ktmizugaki/wifi-voice-clock/circuit/wifi_voice_clock-v3.kicad_pcb

## KiCad design circuit/wifi_voice_clock-v3.kicad_pcb (2022-05-02)

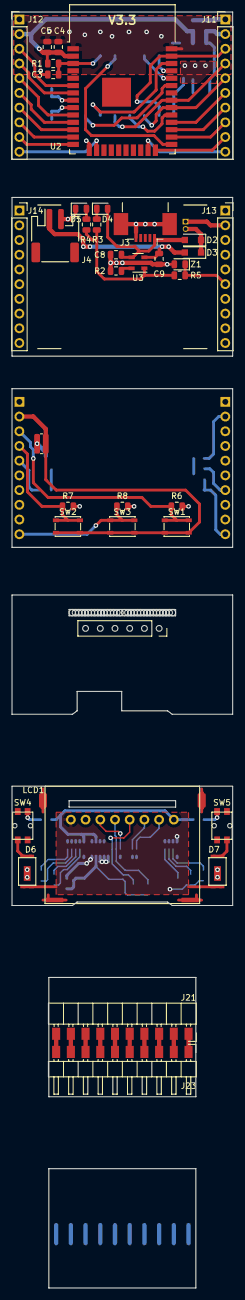
[picture p1: board wifi_voice_clock-v3.kicad_pcb from above]

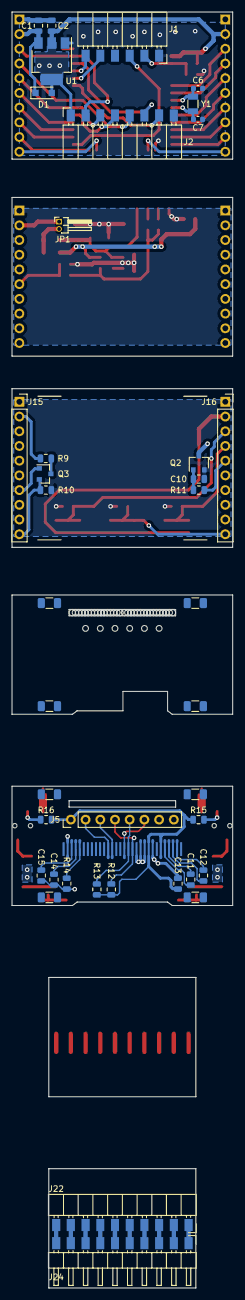
[picture p2: board wifi_voice_clock-v3.kicad_pcb from below]

Board: 2 copper layers, 38.1 x 220.3 mm, 68 parts (31 on the bottom side), 88 nets.

Parts:
C1, C2, C10, C11, C12, C13: 1uF; C_0805_2012Metric
C3, C4: 0.1uF; C_0805_2012Metric
C5, C8, C9: 10uF; C_0805_2012Metric
C6, C7: 15pF; C_0603_1608Metric
C14: 4.7uF; C_0805_2012Metric
C15: 2.2uF; C_0805_2012Metric
D1, D2: GS1010FL; D_SOD-123F
D3: SS2040FL; D_SOD-123F
D4: Orange; LED_0805_2012Metric
D5: Grean; LED_0805_2012Metric
D6, D7: SPMWHT541MD5WAR0SD; LM561B
J1: PinSocket 1x06 5.7mm; PinSocket_1x06_P2.54mm_5.7mm_Horizontal_SMD
J2: PinSocket 1x08 5.7mm; PinSocket_1x08_P2.54mm_5.7mm_Horizontal_SMD
J3: USB_B_Mini; USB_Mini-B_Hirose_UX60SC-MB-5ST
J4: BATTERY; JST_PH_S2B-PH-SM4-TB_1x02-1MP_P2.00mm_Horizontal
J5: PinHeader 1x08 7.7mm; PinHeader_1x08_P2.54mm_Vertical
J11, J12: PinHeader 1x10 7.7mm; PinHeader_1x10_P2.54mm_Vertical
J13, J14, J15, J16: PinSocket 1x10 3.5mm; PinSocket_1x10_P2.54mm_Vertical
J21, J22: PinSocket 1x10 3.5mm; PinSocket_1x10_P2.54mm_3.5mm_Horizontal_SMD
J23, J24: PinHeader 1x10 3mm; PinHeader_1x10_P2.54mm_3mm_Horizontal_SMD
JP1: Jumper; PinHeader_1x02_P1.27mm_Horizontal
LCD1: ER-OLED0.96; OLED0.96
LS1: CES-20134-088PM; R_0612_1632Metric
Q2: 2SC3265-Y; SC-59
Q3: BSS138; SOT-23
R1, R2, R5, R6, R7, R8, R10, R12, R13: 10K; R_0805_2012Metric
R3, R4: 470; R_0805_2012Metric
R9: 40K; R_0805_2012Metric
R11: 820; R_0805_2012Metric
R14: 910K; R_0805_2012Metric
R15, R16: 1K; R_0805_2012Metric
SW1, SW2, SW3: SW_Push; SW_SPST_PTS810
SW4, SW5: THAU13
U1: ADP3338AKCZ-3.3; SOT-223-3_TabPin2
U2: ESP32-WROOM-32D; ESP32-WROOM-32
U3: MCP73831-2-OT; SOT-23-5
Y1: FC-135; Crystal_SMD_3215-2Pin_3.2x1.5mm
Z1: 3.3V; D_0805_2012Metric

Connections:
+3V3: C2.1, C4.2, C5.2, D1.2, J2.1, J12.2, R1.2, U1.2, U2.2
+5V: C8.1, D2.2, D4.2, J3.1, U3.4
+BATT: C9.2, D3.2, J4.1, U3.3
/CHGR_GND: C8.2, C9.1, D5.1, J3.5, J3.6, J4.2, J13.1, J14.1, R2.1, U3.2, Z1.2
/CHGR_STAT: J13.6, R5.2, Z1.1
/CHGR_VCC: J13.2, JP1.1
/CPU_EN: C3.1, J1.2, R1.1, U2.3
/CPU_IO0: J1.3, U2.25
/CPU_IO2: J11.9, U2.24
/CPU_IO4: J11.8, U2.26
/CPU_IO12: J12.9, U2.14
/CPU_IO13: J12.10, U2.16
/CPU_IO14: J12.8, U2.13
/CPU_IO15: J11.10, U2.23
/CPU_IO16: J11.7, U2.27
/CPU_IO17: J11.6, U2.28
/CPU_IO27: J12.7, U2.12
/CPU_RXD0: J1.5, U2.34
/CPU_SPK: J12.5, U2.10
/CPU_SPK2: J12.6, U2.11
/CPU_SW1: J12.3, U2.6
/CPU_SW2: J12.4, U2.7
/CPU_TXD0: J1.6, U2.35
/CPU_VSPICLK: J2.3, J11.5, U2.30
/CPU_VSPICS0: J2.4, U2.29
/CPU_VSPID: J2.2, J11.3, U2.37
/CPU_VSPIHD: J2.7, U2.33
/CPU_VSPIQ: J2.5, J11.4, U2.31
/CPU_VSPIWP: J2.6, U2.36
/CTRL_3V3: J16.2, LS1.1, SW1.2, SW2.2, SW3.2
/CTRL_GND: C10.2, J15.1, J16.1, Q2.2, R6.1, R7.1, R8.1, R10.1
/CTRL_SPK: J16.5, R11.2
/CTRL_SW1: J16.3, R6.2, SW1.1
/CTRL_SW2: J16.4, R7.2, SW2.1
/CTRL_SW3: J16.10, R8.2, SW3.1
/CTRL_VCC: J15.2, R9.2
/CTRL_VMES: J15.10, Q3.2, R10.2
/CTRL_VOUT: J15.7, Q3.1
/LCD_3V3: C13.2, J5.1, LCD1.6, LCD1.9, R12.2, R13.2, R15.2, R16.2
/LCD_GND: C13.1, C14.2, C15.2, D6.1, D7.1, J5.8, LCD1.8, LCD1.10, LCD1.11, LCD1.12, LCD1.29, R14.2
/LCD_LCDRS: J5.6, LCD1.15
/LCD_SCLK: J5.3, LCD1.18
/LCD_SDI: J5.2, LCD1.19
/MCP73831_STAT: R3.1, R4.1, R5.1, U3.1
/~LCD_LCDCS: J5.4, LCD1.13, R12.1
/~LCD_LCDRST: J5.5, LCD1.14, R13.1
GND: C1.2, C2.2, C3.2, C4.1, C5.1, C6.1, C7.1, J1.1, J2.8, J11.1, J12.1, U1.1, U2.1, U2.15, U2.38
unnamed: C6.2, U2.8, Y1.1
unnamed: C7.2, U2.9, Y1.2
unnamed: C10.1, Q2.1, R11.1
unnamed: C11.1, LCD1.4
unnamed: C11.2, LCD1.5
unnamed: C12.1, LCD1.2
unnamed: C12.2, LCD1.3
unnamed: C14.1, LCD1.27
unnamed: C15.1, LCD1.28
unnamed: D2.1, D3.1, JP1.2
unnamed: D4.1, R3.2
unnamed: D5.2, R4.2
unnamed: D6.2, SW4.1
unnamed: D7.2, SW5.1
unnamed: J21.1, J23.1
unnamed: J21.2, J23.2
unnamed: J21.3, J23.3
unnamed: J21.4, J23.4
unnamed: J21.5, J23.5
unnamed: J21.6, J23.6
unnamed: J21.7, J23.7
unnamed: J21.8, J23.8
unnamed: J21.9, J23.9
unnamed: J21.10, J23.10
unnamed: J22.1, J24.1
unnamed: J22.2, J24.2
unnamed: J22.3, J24.3
unnamed: J22.4, J24.4
unnamed: J22.5, J24.5
unnamed: J22.6, J24.6
unnamed: J22.7, J24.7
unnamed: J22.8, J24.8
unnamed: J22.9, J24.9
unnamed: J22.10, J24.10
unnamed: LCD1.26, R14.1
unnamed: LS1.2, Q2.3
unnamed: Q3.3, R9.1
unnamed: R2.2, U3.5
unnamed: R15.1, SW4.2
unnamed: R16.1, SW5.2
VCC: C1.1, D1.1, J11.2, U1.3
