ktmizugaki/wifi-voice-clock/(commit log)

2021-07-06 Add circuit and gerver
    [wifi_voice_clock-v3.kicad_pcb, wifi_voice_clock-v3.sch]
2021-07-07 Add prog skelton
    [partitions.csv]
2021-09-14 Add switches
2021-10-03 Add ssd1306 driver
2021-10-06 Add power management and wakeup timer
2021-10-25 Check battery level before starting wifi
2021-11-11 Document switches
2021-11-20 Measure real input voltage
    Circuit is from https://jeelabs.org/2013/05/17/zero-powe-battery-measurement/
    [wifi_voice_clock-v3.kicad_pcb, wifi_voice_clock-v3.sch]
2021-12-05 Disable print time for release build
2021-12-26 Show date by right button
2022-03-08 Swap function of middle click and middle long
    [app_mode_clock.c]
2022-03-08 Show battery level on clock
2022-03-30 Adjust OLED footprint
    [wifi_voice_clock-v3.kicad_pcb]
2022-05-02 Update pcb version and gerber to 3.3
    [wifi_voice_clock-v3.kicad_pcb]
2022-05-02 Add "Battery voltage measurement" log
